CreativeRobotics/EnactiveTorchRT2b/README.md

# EnactiveTorchRT2b

Res
 Enactive Torch RT2 Hardware Revision b source files.
