CreativeRobotics/EnactiveTorchRT2b/Documentation/ETRT2BatteryStatement.pdf

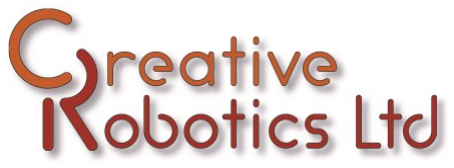
[picture p1: figure]

Copyright © Creative Robotics Ltd 2019

### www.creative-robotics.com support@creative-robotics.com

Enactive Torch RT 2.0

This device contains a 7.4 watt hour Lithium Battery fitted inside the equipment.

Battery specifications

Manufacturer: | RS Components
Manufacturer website: | www.rswww.com
Datasheet: | https://tinyurl.com/yyvgdmx6
Manufacturer part number: | 125-1266
Battery type: | polymer Li-ion Rechargeable Battery
Weight: | 40.0g
Nominal Voltage: | 3.7V
Nominal Capacity: | 2000Ah
Maximum Continuous Discharge Current: | 2000mA
