CreativeRobotics/EnactiveTorchRT2b/Documentation/ETRT2UserGuides_Revb.pdf

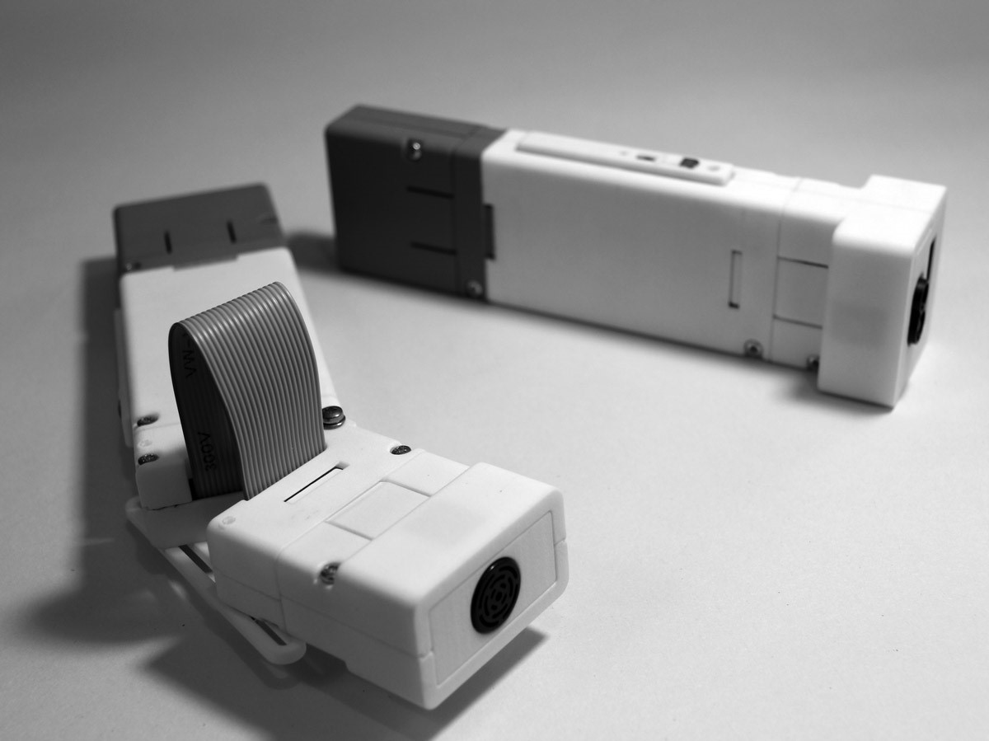
[picture p2: figure]

Copyright © Creative Robotics Ltd 2020 – DCU Hardware Revision b

www.creative-robotics.com
support@creative-robotics.com

# ENACTIVE TORCH RT 2 USER GUIDE

For DCU hardware Revision b

### Contents

### Introduction

The Enactive Torch RT 2 consists of three modules, a Data Capture Unit (DCU), input module and output module. The three modules clip together to form a working device.

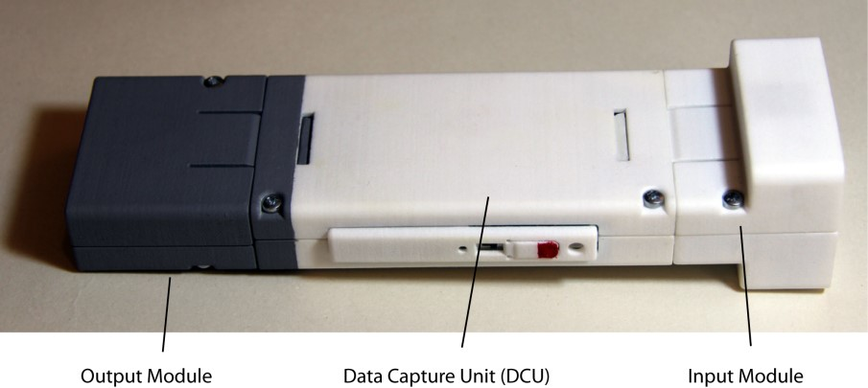
[picture p3: figure]

Data Capture Unit (DCU)
The Data Capture Unit is the core of the device. It contains the main processor, wifi module, inertial sensors and battery along with the user button and switch, USB port and micro SD card.

Input and output ports are located at each end of the DCU, one for a sensor input module and the other for the output module. The two ports use polarised connectors to prevent the modules being connected the wrong way around, and the case uses clip connectors to secure them in place. The two

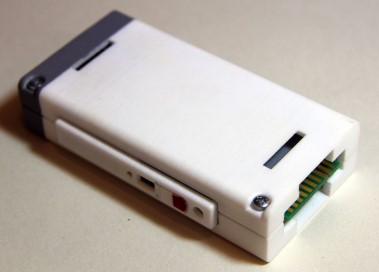
[picture p4: figure]

ends are also colour coded with the output module end coloured grey.

The USB port, power switch and SD card is located on one side of the DCU whilst the User LED, User button and switch and a device reset button are located on the opposite side.

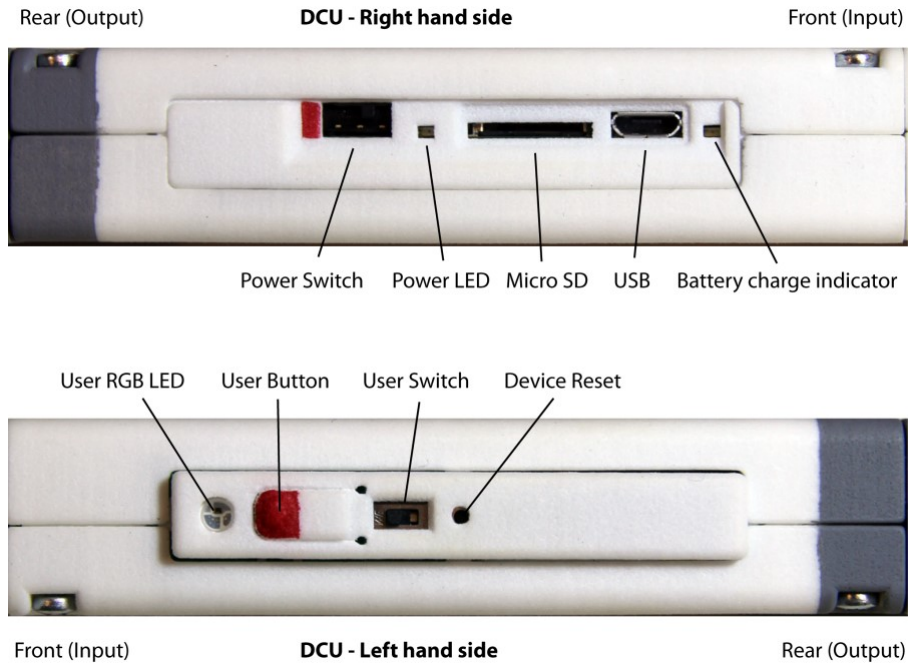
[picture p5: figure]

Clip connectors
The input and output modules connect to each end of the DCU. The connectors have white polarising pins that prevent them from being connected the wrong way.

Input Module

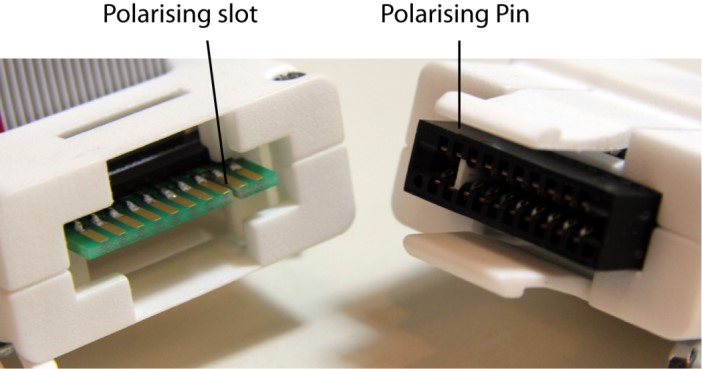
[picture p6: figure]

Input modules consist of a sensor or sensors that connect to the front of the device. A number of different input sensors can be connected to provide different functionality.

Sensor Modules

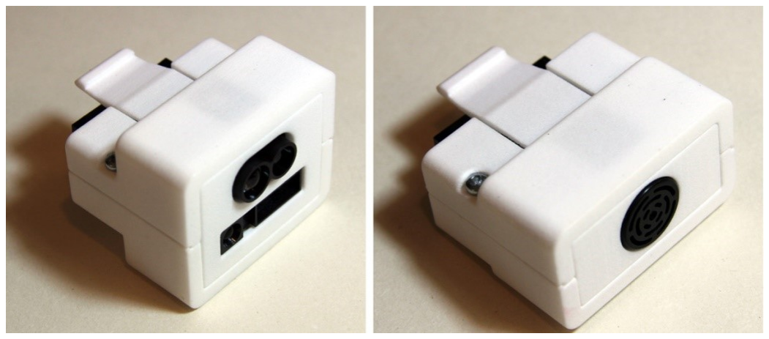
[picture p7: figure]

1: Two input modules - Dual LIDAR (Left) and Sonar (Right)

Output Module
The output module connects to the rear of the DCU and is used to produce output signals from the DCU, for example haptic feedback signals to drive different types of haptic actuator. More details can be found on page 13.

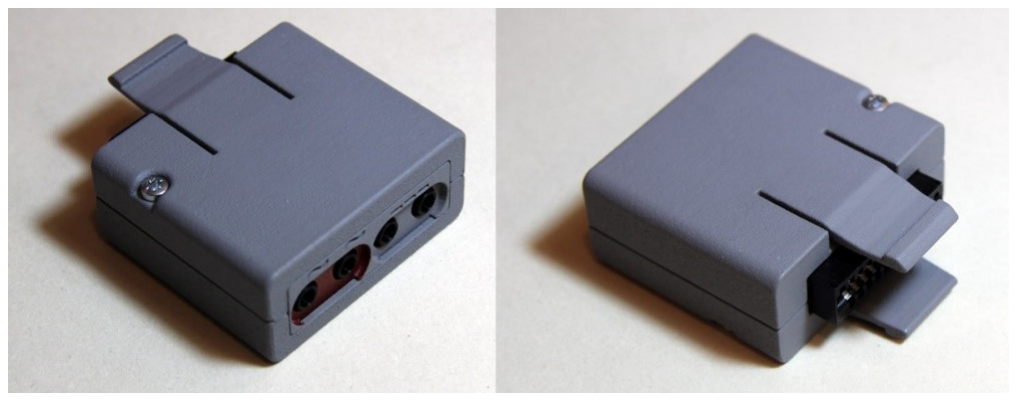
[picture p8: figure]

### Basic operation

Startup procedure
When the DCU is switched on it will check for the presence of an SD card and, if found, it will then look for a file called settings.txt.

If the settings file is found it will open it and read the contents which should be a series of commands for configuring the device.

The command system
The DCU has a text based command system that can be used to configure the device. Commands can be sent over a USB connection, by Bluetooth and by WiFi using Telnet (Some of these functions are not working yet)

Documentation for the commands can be found on page 15.

The settings file can also be used to issue commands when the device is switched on and is the primary way to control the devices configuration. In particular it can be used to instruct the WiFi module to connect to a WiFi access point using a specified password.

Entering commands via the USB port.
To enter commands using the USB port, first connect the DCU to a computer using a USB cable. Connect to the DCU using a terminal emulator or serial port application. If the Arduino IDE is installed then the in built Serial monitor can be used. The USB serial port settings are:
- 115200 baud
- 1 Stop bit
- No parity

The DCU will appear as an “Adafruit Metro M4 (SAMD51)” USB device.

When the DCU is connected and switched on and the Serial monitor is opened up, type the command ‘get status’ and press enter to read the device configuration status. To get a list of commands type ‘help’ and press enter.

### Software Installation

The DCU can be programmed using the Arduino development environment. The Arduino IDE is open source and free to download for PC, MAC and Linux. The DCU requires some additional files in order to work.

Installing and configuring Arduino
Download the version of Arduino for your computer from here:

https://www.arduino.cc/en/Main/Software

Follow the Arduino installation instructions for your system here:

https://www.arduino.cc/en/Guide/HomePage

Open Arduino and open File->Preferences. A dialog box will appear. At the bottom, click the button on the right of the text entry field called ‘Additional Board Manager URLs’ and paste the following onto a new line in the box before closing the dialog boxes and restarting Arduino.

https://adafruit.github.io/arduino-board-index/package_adafruit_index.json

Installing the Arduino and Adafruit SAMD cores
The code for the ETRT depends on several ‘core distributions’ for Arduino which contain essential code for the ETRT processors.

Open the Board manager in Arduino in Tools->Board->Boards Manager and search for’ samd’. Install the Arduino SAMD Boards (32-bits ARM Cortex-M0+) package.

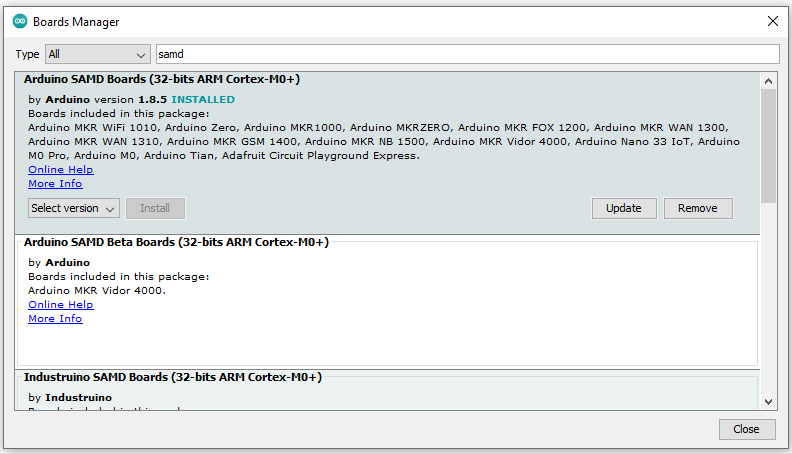
[picture p9: figure]

Now search for ‘Adafruit’ and install the ‘Adafruit SAMD Boards’ Package.

Installing the Creative Robotics Arduino core
The DCU works with a customised version of the Arduino software core, derived from the Adafruit SAMD core, which is in turn derived from the Arduino SAMD core. It can be downloaded from here:

https://github.com/CreativeRobotics/ArduinoCore-samd/archive/master.zip

1. Unzip the contents of the file.
2. The unzipped folder will be called ‘ArduinoCore-samd-master’ – Rename this to ‘samd’.

3. Locate the Arduino Sketch folder on your computer
4. Inside the sketch folder look for a folder called ‘hardware’ – if it does not exist then create it.
5. Inside the ‘hardware’ folder create another folder called ‘CreativeRobotics’.
6. Copy the ‘samd’ folder from step 2 into the ‘CreativeRobotics’ folder.

To check that the installation has worked properly start or restart the Arduino IDE and look in the Tools->Board menu. You should see a list of boards under the heading “Creative Robotics SAMD (32-bit ARM Cortex M0+ and M4) Boards”

Select the “Enactive Torch RT2 REVb (SAMD51)” option.

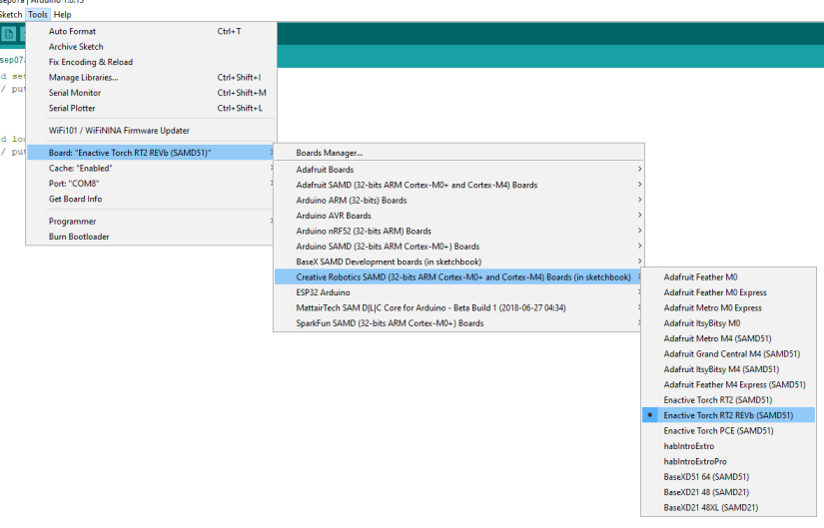
[picture p10: figure]

Installing the DCU firmware source code for Arduino
The full set of hardware and software for the ETRT2 revision B, including source code for the DCU firmware can be downloaded from here:

https://github.com/CreativeRobotics/EnactiveTorchRT2b/archive/master.zip

To set up the software to work with Arduino first unzip the files and locate the ‘ETRT-DCU1’ folder inside ‘Firmware/ (https://github.com/CreativeRobotics/EnactiveTorchRT2b/tree/master/Firmware)DCU/ (https://github.com/CreativeRobotics/EnactiveTorchRT2b/tree/master/Firmware/DCU)FW Revision B/ETRT-DCU1’ (https://github.com/CreativeRobotics/EnactiveTorchRT2b/tree/master/Firmware/DCU/FW%20Revision%20B) and copy this into your Arduino Sketchbook folder.

In order to compile the software you also need to install some third party libraries. This can be done with the Arduino Libraries manager.

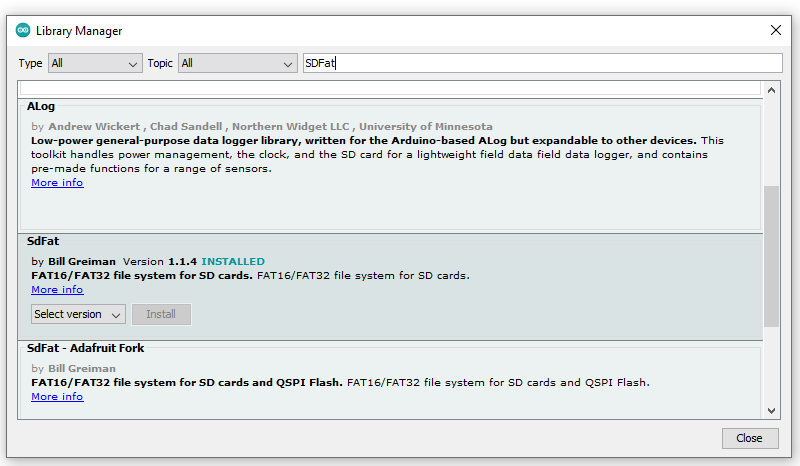
[picture p11: figure]

In the Arduino IDE open the ‘Sketch->Include Library’ menu and select ‘Manage Libraries…’.

Using the Library Manager, search for SDFat, and install the library.

When complete, restart Arduino, navigate to the location of the ETRT software in the sketchbook and open the file called ETRT-DCU1.ino.

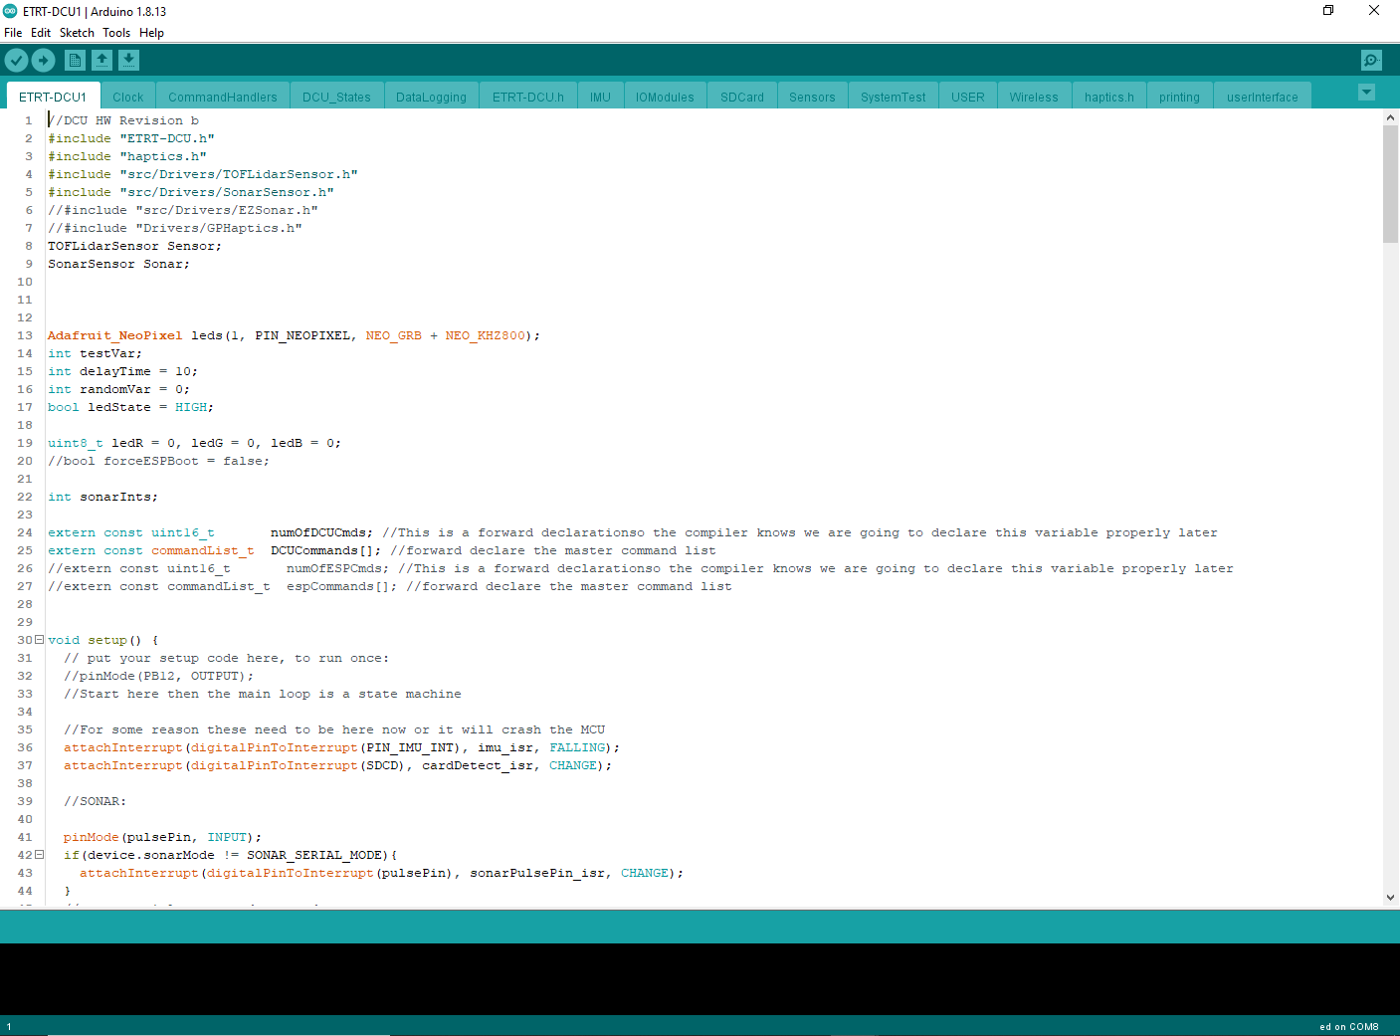
[picture p12: figure]

Connecting the DCU to Arduino
Attach the DCU to the computer using the USB cable and switch the DCU on. The computer should automatically recognise it as a USB serial device.

In Tools->Port the ETRT should be listed, it may be displayed with the name “Adafruit Metro M4 (SAMD51)” or “Enactive Torch RT2 Revb”. Select this as the serial port.

In Arduino, select Tools->Serial Monitor to open the serial port terminal. Set the baud rate to 115200 baud using the drop down menu next to the ‘clear output’ button.

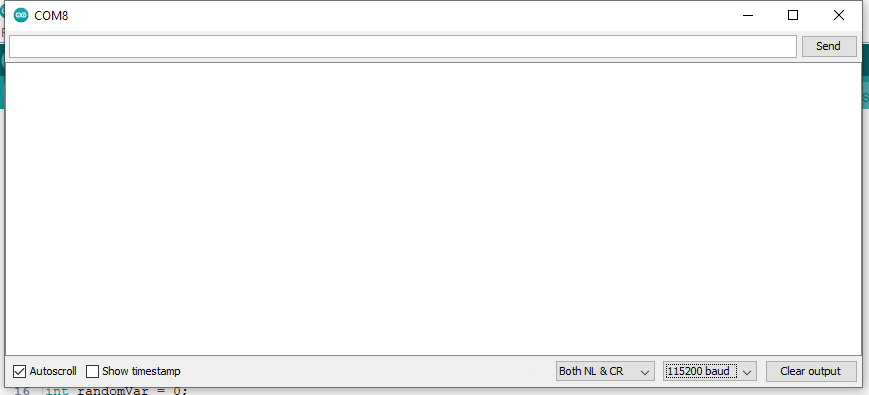
[picture p13: figure]

If the DCU has booted up and the serial monitor is connected the DCU should respond to the ‘help’ command by providing a list of commands.

To compile and upload code, click on the upload button in the Arduino IDE (The right facing arrow at the top left). The code will compile and then be uploaded to the DCU. If the Serial monitor is left open it will be greyed out during the upload and if the upload is successful the device will print boot status information as it restarts.

If the attempt to upload fails the Serial monitor should be closed and the DCU reset into bootloader mode. This can be done by pressing the reset button twice in rapid succession. The indicator LED will appear green when the device is in bootloader mode – When in this mode the device will appear as a different USB port, this port must be selected before attempting to upload code. If the upload is successful the device will re-appear as a new serial port which must then be selected before the serial monitor is reopened.

### Data Capture Unit

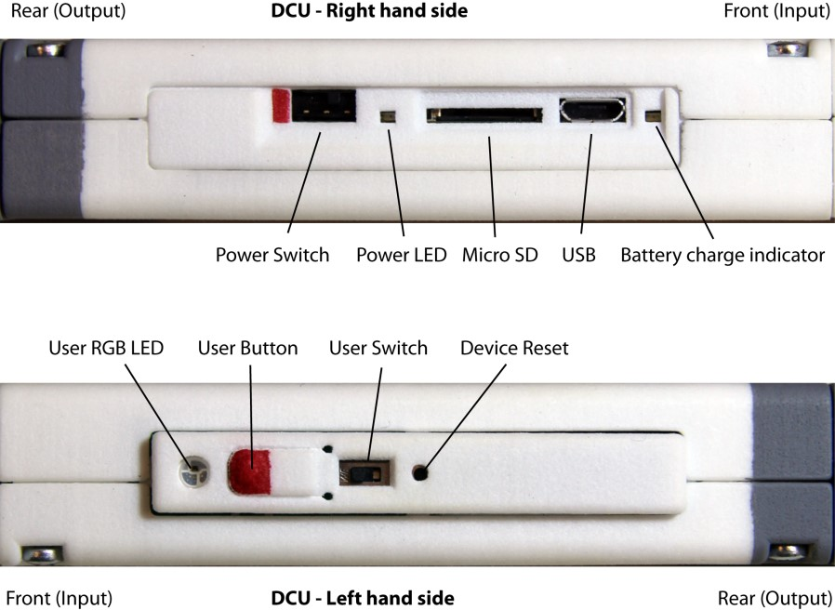
[picture p14: figure]

The Data Capture Unit (DCU) is the core of the device, it provides power, USB and wireless connectivity and supports the Micro SD card reader. It also incorporates a 9 axis inertial measurement unit to track the orientation of the unit.

The DCU has two connectors at each end, one for attaching a distance sensing module, and the other for attaching a haptic driver module. The connectors have a polarising pin so the haptic module can only be plugged into the output of the DCU. With these modules attached, the DCU can read range data from the distance sensor module and translate it to haptic signals. It can also log this and other sensor data to the SD card and broadcast it over a Bluetooth connection, or over WiFI using the UDP data protocol.

The power switch ON position is where the switch is slit towards the rear of the device (the grey end). The user switch is in the ON position when in the forward position (towards the front)

### Sensor Modules

There are currently two sensor modules that can be used with the DCU. The DCU will automatically detect the type of sensor that is attached to it when powered up.

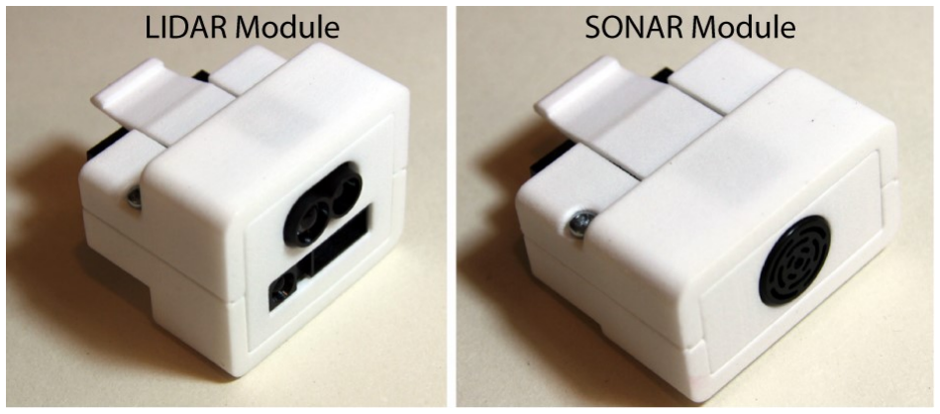
[picture p15: figure]

Lidar
The Lidar module uses a time of flight lidar sensor that measures distance by sensing out a pulse of infra-red light and measuring the time it takes to receive a return signal. This sensor can measure distances between 30cm and 1200cm with a resolution of 1cm and a frequency of 100Hz.

The module also incorporates a second infra-red rangefinder that can measure distances from 4cm to 30cm.

Details of the Lidar and IR rangefinder cab be found here:

https://www.seeedstudio.com/Seeedstudio-Grove-TF-Mini-LiDAR.html

http://www.sharp-world.com/products/device/lineup/data/pdf/datasheet/gp2y0a41sk_e.pdf

Sonar
The sonar module uses ultrasonic sound to measure distance. The sensor is an MB1010 LV-MaxSonar-EZ1 sensor from Maxbotics. It can measure distances between 15cm and 645cm with a resolution of 2.54cm and a frequency of 20Hz.

https://www.maxbotix.com/documents/MB1010_Datasheet.pdf

### Haptic Modules

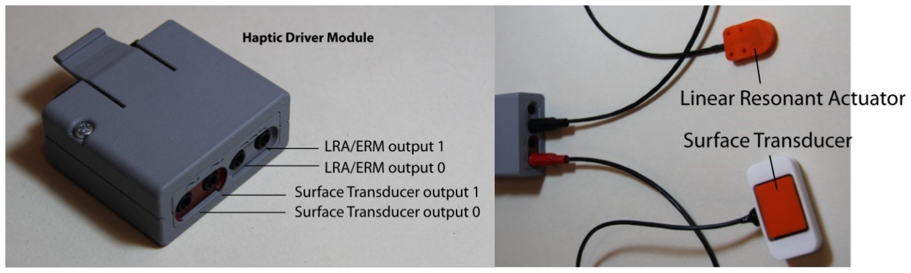
[picture p16: figure]

ERM/LRA and Surface Transducer module
This module combines two types of haptic driver, each with two channels.

ERM/LRA drivers
The ERM/LRA drivers control conventional vibration motors and can be configured in software for two modes of operation:

In LRA mode it will drive Linear Resonant Actuators, these are a type of vibration motor containing a magnetic coil, mass and spring, and will resonate at a certain frequency when driven correctly and allow the intensity to be controlled. The LRA actuators supplied with the module will resonate at approximately 200Hz.

In ERM mode the device can drive Eccentric Rotating Mass actuators. These are conventional miniature motors with an eccentric mass attached to their output shaft which causes them to vibrate when the motor is spinning. The speed of the motor, and consequently the intensity of the vibration, can be controlled in software. With these actuators the vibration frequency and intensity are coupled together so increasing intensity also increases frequency.

Surface Transducer drivers
The surface Transducer drivers produce class B audio signals using a 2.5 audio Watt amplifier. They can be used to drive surface transducers. These are a type of actuator consisting of a magnetic coil and magnet and operate in exactly the same way as audio loudspeakers.

Surface transducers allow for independent control over frequency and intensity so it is possible to map two different sensor signals into their haptic output.

The default mode of operation for the surface transducers is conventional sensor to intensity mapping where the actuators are driven by a sine wave of varying intensity. A number of different signals can be chosen for driving the module this way, for example triangle waves and saw tooth waves.

### Getting started

Default firmware behaviour
The DCU will come with default firmware installed, and a default settings.txt file on the SD card. With the default firmware installed, the device will operate as follows.

The user button activates the sensor to haptic mapping and will trigger data capture. Pressing the user button will toggle between active and inactive modes, and the LED will change colour to indicate which mode it is in.

When the device is active, sensor inputs will be mapped to all four haptic outputs and data will be logged to the data channels as specified below, when the device is inactive, the haptic outputs are disabled and data streaming is halted.

The user switch controls whether data is just streamed over USB and wireless connections, or whether it is also logged to an SD card. The streaming options for the device are controlled using the start up configuration which the device reads from the ‘settings.txt’ file on the SD card. By default streaming over USB is enabled.

When the user switch is in the OFF position (towards the rear) and the user button is pressed, the DCU will stream data over USB and any wireless connection it has been configured to use.

When the switch is ON (toward the front) the DCU will create an SD log file whenever the user button is pressed, and log data to this file for as long as the user keeps the button pressed. When the user releases the button the log file is closed. The DCU will also stream this data over any connection it has been configured to use.

### Configuring the DCU

The DCU has a set of commands that can be used to control configuration. These Commands can be accessed using the USB port and a Serial Terminal application, or through a wireless connection such as Bluetooth or Telnet.

The settings file
The default configuration when the device starts up can be controlled with the same command set, but with a file on the SD card. When the DCU is switched on it will look for an SD card and for a file called ‘settings.txt’. If it finds this file it will read and process any commands in the file.

The settings file MUST include a blank line at the end of the file.

A full list of commands can be found in the next section.

Example settings file

#ETRT SETTINGS

#DCU SETTINGS

#Lines starting with HASH (#) are ignored DEBUG:if the settings file is empty thats fine #Data log settings - what to log

setlog quaternion false
setlog YPR true
setlog gyro false
setlog accellerometer false setlog magnetometer false
setlog heading false
setlog inputs true
setlog outputs true
#Data log settings - where to log setlog USB false

setlog UDP false
setlog SD false
setlog bluetooth false
#Set biases for IMU

#set gyro bias 0,0,0

#set accel bias 0,0,0

#set mag bias 0,0,0

#use for configuring wifi

#set SSID myssid

#set set Pass mypassword

enable bluetooth

Anything preceded by the # symbol will be ignored so this symbol can be used to insert comments or disable commands. The command DEBUG can be used to print messages – anything after a DEBUG command will be printed over the USB port.

The first group of settings all use the ‘setlog’ command to configure which different parameters will be logged to file, and streamed over any data connections.

The second set of ‘setlog’ commands will enable or disable different channels for data logging. In the example only USB is enabled by default – but during operation logging to SD card can be switched ON or OFF with the user switch.

The next set of commands set bias values for the inertial measurement unit. These will normally be unique to each device and can be obtained by performing a calibration run (To Be Done)

The next set of commands set the network name (SSID) and password for WiFi conections. These are only used if the WiFi service is subsequently enabled. The command to enable WiFi must be used AFTER the password and SSID commands.

The final command enables the communications module as a Bluetooth device. This can be changed to enable WiFi and one of the WiFi services if required.

The DCU can use Bluetooth and WiFi simultaneously but the connections may become unreliable so it is best to use only one of these services.

### DCU Command List

Note: This is a list of all command words that the device recognises. Some are only used for device to device communication, for example the ack and nack commands are simple acknowledge messages, and the DEBUG: command marks a command as containing debug information which it should simply ignore.

get status

Arguments: none

Returns:

get device status information

set time

Arguments: HH:MM:SS

Returns:

set the time. Syntax: set time [HH]:[MM]:[SS] – Hours, Minutes and Seconds separated with a colon.

get time

Arguments: none

Returns:

get the device time

set date

Arguments: DD:MM:YYYY

Returns:

Set the date Syntax: set time [DD]:[MM]:[YYYY]

get date

Arguments: | none
Returns: | none

Get the device date

get raw voltage

Arguments: none

Returns:

Get the device raw voltage reading

get settings

Arguments: none

Returns:

Print out the device settings

set precision

Arguments: integer - for example 4 (4 decimal places)

Returns:

Sets the number of decimal places for data logging. Example: set precision 5

set aux power

Arguments: on / off

Returns:

Turn the auxiliary 5V power regulator on or off. Syntax: set aux power on

sleep

Arguments: | none
Returns: | none

Puts the device to sleep – COMMAND NOT FUNCTIONAL

restart

Arguments: | none
Returns: | none

restarts the DCU

set SSID

Arguments: SSID name

Returns:

Sets the SSID for WiFI. Syntax: set SSID mydssidname

set Pass

Arguments: Network Password

Returns:

Sets the password for WiFI. Syntax: set Pass mypassword

enable server

Arguments: none

Returns:

Starts the HTTP server

disable server

Arguments: none

Returns:

Stope the HTTP server

enable telnet

Arguments: none

Returns: none

Starts the Telnet service

disable telnet

Arguments: | none
Returns: | none

Stops the Telnet service

enable bluetooth

Arguments: | none
Returns: | none

Starts the Bluetooth service

disable bluetooth

Arguments: | none
Returns: | none

Stops the Bluetooth service

enable UDP

Arguments: | none
Returns: | none

Starts the UDP service

disable UDP

Arguments: | none
Returns: | none

Stops the UDP service

startlog

Arguments: | none
Returns: | none

Starts logging data to the configured data channels

stoplog

Arguments: | none
Returns: | none

Stops logging data

setlog

Arguments: | setlog sub command + true/false
Returns: | none

Configure which types of data are to be logged and where to send it (SD, USB, UDP, Bluetooth).

Examples:

setlog quaternion true

setlog USB true

Sub command list:

quaternion | 4 axis quaternion IMU data
YPR | Yaw Pitch and Roll data
gyro | Gyro XYZ data
accel | Accelerometer XYZ data
mag | Magnetometer XYZ data
heading | Heading (compass) data
inputs | Device sensor inputs
outputs | Device haptic outputs

SD | Enable/Disable SD card logging
UDP | Enable/Disable UDP data streaming
Bluetooth | Enable/Disable Bluetooth data streaming
USB | Enable/Disable USB data streaming

get log header

Arguments: none

Returns: String of text

Gets the header for the log file with names for each column of data as specified by the log configuration.

SD

Arguments: | none
Returns: | none

Invokes the SD file navigation sub commands.

This command will load a sub command list with some basic SD file navigation commands. These commands can
| be viewed using the ‘help command.

start haptest

Arguments: | none
Returns: | none

Start testing the haptics

stop haptest

Arguments: | none
Returns: | none

Stop testing the haptics

set waveform

Arguments: | Chanel WAVEFORM
Returns: | none

Set the waveform type.

Example: set waveform 0 SINE

Sets the waveform for channel 0 to a sine wave.

Waveform arguments:

SINE | Sine wave
SQUARE | Square wave
TRIANGLE | Triangle wave
SAWF | Sawtooth (forwards)
SAWB | Sawtooth (reverse)
ONESHOT | (Single pulse sequence)
HALFSHOT | (Half pulse sequence)

set gyro bias

Arguments: | x,y,z
Returns: | none

Set the Gyro bias values with three comma separated integers. Syntax:set gyro bias [x],[y],[z]

set accel bias

Arguments: | x,y,z
Returns: | none

Set the Accelerometer bias values with three comma separated integers. Syntax:set accel bias [x],[y],[z]

set mag bias

Arguments: x,y,z

Returns: none

Set the magnetometer bias values with three comma seperated integers. Syntax:set mag bias [x],[y],[z]

ESP Boot

Arguments: | none
Returns: | none

Restart the ESP32 wifi module in bootloader mode

ESP RESET

Arguments: | none
Returns: | none

Reset the ESP32 wifi module

ESP Status:

Arguments: | none
Returns: | none

An ESP32 WiFi module Status message.

ESP Get:

Arguments: | none
Returns: | none

Marks HTML data sent to the WiFI module for it to send to a client.

ESPTelnet:

Arguments: | none
Returns: | none

Marks data as coming from a Telnet client.

ESP:

Arguments: | none
Returns: | none

Route the command to the ESP32 WiFi Module.

testSD

Arguments: | none
Returns: | none

Test the SD by opening writing and closing a file.

button action

Arguments: | sub command + true/false
Returns: | none

Enable or disable various button actions. This determines the behaviour of the user button with the default firmware. The three sub commands that can be used are as follows, and should be followed by either ‘true’ or ‘false’.

- | enable haptics | enable the haptics on a user button event
- | enable log | enable data logging on a user button event
- | enable toggle | enable toggling of user button events

By default all are set to true. When ‘enable toggle’ is true the user button will toggle between active and inactive modes. When set to false, pressing the user button will trigger active mode and releasing it will return to inactive mode.

In active mode, haptics and data logging are also active IF they have been enabled as button actions.

In inactive mode haptics and data logging will be inactive.

DEBUG:

Arguments: | none
Returns: | none

Debug message.

ack

Arguments: | none
Returns: | none

Acknowledge.

nack

Arguments: | none
Returns: | none

NOT Acknowledge.

toggle print

Arguments: | none
Returns: | none

Toggle Printing (DEBUGGING).

?

Arguments: | none
Returns: | device information

Query -

help

Arguments: | none
Returns: | help file

Gets a page of information about the current command set.

### ESP32 command list

Command list for the ESP32 WiFi Module. These commands are used by the WiFi/Bluetooth module and are used by the DCU to control the WiFi module..

?

Arguments: None

Query – Returns ack.

Help

Arguments: None

Returns command list.

Ack

Arguments: None

Send an acknowledge.

Nack

Arguments: None

Send a NOT acknowledge.

enable server

Arguments: None

Enable the HTTP Server.

disable server

Arguments: None

Disable the HTTP Server.

enable Bluetooth

Arguments: None

Enable the Bluetooth Serial service.

disable Bluetooth

Arguments: None

Disable the Bluetooth Serial service.

enable UDP

Arguments: None

Enable the UDP broadcast service.

disable UDP

Arguments: None

Disable the UDP broadcast service.

UDPSend:

Arguments: UDP data packet

Send a packet of data over the UDP service.

Example: UDPSend:Sensor=123,Gyro=992

serverSend:

Arguments: HTML line

Send a line of data for the HTTP server to send to a client.

Example: serverSend:<p>some HTML</p>

BTSend:

Arguments: Bluetooth serial data

Send a line of data for transmission via Bluetooth.

Example: BTSend:Sensor=123,Gyro=992

serverEnd

Arguments: None

Tell the server to close the connection to the client – When everything that needs to be sent has been sent.

set UDPPort

Arguments: UDP Port number

Sets the UDP Port number.

Example: set UDPPort 6060

set UDPAddress

Arguments: UDP network address

Sets the network address for UDP data. Default is broadcast address.

Example: set UDPAddress 123.456.789.101

set SSID

Arguments: SSID (Network Name)

Sets the WiFi network name to connect to.

Example: set SSID VM12345

set Pass

Arguments: WiFi Password

Sets the WiFi password.

Example: set Pass mypassw0rd

set Server Timeout

Arguments: time in milliseconds

Sets the timeout period in milliseconds after which the HTTP server will close a client connection.

set BTName

Arguments: Bluetooth device name.

Sets the Bluetooth device name.

Example: set BTName ETNumber2

connect to

Arguments: SSID and Password (Separated by one space)

Attempts to connect to a WiFi network using the SSID and Password in the arguments.

Example: connect to VM12345 mypassw0rd

set WiFi Timeout

Arguments: Time in milliseconds

Sets the timeout period after which an attempt to connect to WiFi is abandoned. Minimum is 1000 (1 Second).

Example: set WiFi Timeout 10000

Disconnect

Arguments: None

Disconnects from WiFi.
