CreativeRobotics/EnactiveTorchRT2b/Hardware/PerceptualCrossing/Display Head Disassembly.txt

Follow this link to view a video file of the disassembly steps.

https://www.dropbox.com/s/dvkhhiwpnt47x4t/Disassembly%20Animation.avi?dl=0
