CreativeRobotics/EnactiveTorchRT2b/(threads)

Thread 1 (2020-04-20):

LIDAR distance jumps to high values

kercos, 2020-04-20:
When opening the serial plotter we noticed that LIDAR distance signal (blue line) at random time (usually when you move the torch) jumps to very high levels (>>12000) for few data points. See attached screenshots.
This problem does not occur with SONAR input.

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

CreativeRobotics, 2020-04-29:
The LIDAR modules are supposed to send a checksum as part of a data packet, but when tested the checksum was always 0 - this may be a firmware bug in the devices. Without a checksum it is not possible to establish if a packet is valid or not so errors can appear as unusual values. I've attempted to mitigate this by capping the raw data values to within the measurement range of the device. If this still causes problems then some additional filtering may be required. (The files for this and other fixes will be released in the next few days).

I don't currently have a LIDAR module to test updated code with, but I have just ordered one.

Closed 2020-04-29.

Thread 2 (2020-04-20):

SONAR doesn’t trigger haptic outputs

kercos, 2020-04-20:
SONAR input value seems reliable but when connecting haptic modules in output nothing happens.
The same haptic modules work if the input unit is LIDAR.

CreativeRobotics, 2020-04-30:
I've been testing this with the unit I have here and I do get normal haptic outputs with the sonar module - both for the Linear Resonant Actuator haptics and the Surface Transducers. I will finish up a few more tests and then update the code in the repo with the updates for other issues, then we will have to look at this issue again.

CreativeRobotics, 2020-04-30:
Remember - you cannot hot swap the sensor modules at the moment. The sensor type recognition happens during power up so changing them when the device is powered on will cause it to misbehave. I will look at changing this because I imagine hot swapping might be useful.

kercos, 2020-05-04:
@CreativeRobotics Update on this issue.
I've tried again and found out that with SONAR input only Surface Transducer works but very faintly and only on a very short range (max 10cm). It works also when I connect it after booting the device.
But with LRE/ERM sensor I could still not perceive any haptic feedback even when connected before booting the device.

Thread 3 (2020-04-20):

CSV output extra column

kercos, 2020-04-20:
Output in the CSV has one more column wrt the headers (IMU heading value is always printed).

CreativeRobotics, 2020-05-08:
This should be fixed now

Closed 2020-05-08.

Thread 5 (2020-04-20):

Update SONAR to user original driver

kercos, 2020-04-20:
SONAR original driver not being used and not reading incoming serial bytes.

CreativeRobotics, 2020-04-29:
SONAR will not work with serial because the serial data is inverted - it appears the Maxbotics SONAR module outputs serial data at logic level, but inverted as if sent via RS232. The SERCOM hardware module  cannot be configured to read inverted serial values so the only way to make this work is with additional hardware to invert the SONAR serial stream.

The default SONAR data read mode is to read PWM pulse lengths. The SONAR module outputs a PWM signal with a pulse of 147us per inch. This is read using interrupts to capture the pulse length, and is converted to cm.

Closed 2020-04-29.

Thread 6 (2020-04-20):

Enable printing of debug messages in code

kercos, 2020-04-20:
There seems to be no way to enable the printing of debug messages in the code.
There seems to be the `toggle print` command specific for this purpose, but it doesn't seem to work.
I've noticed that in the last commit (https://github.com/CreativeRobotics/EnactiveTorchRT2b/commit/e379dda2c45291f696694369003d7f4c07e5214f) this command has been replaced by `debug` but this is not being recognized. Is it because we need to update the code in each ESP32 board? If so, how can we do that?

CreativeRobotics, 2020-05-04:
The debug command in the latest comit worked fine for me, and I get debug messages when it is enabled. I will upload a new commit soon, and double check that all the uploaded files are correct - there could be a discrepancy between what I have on my system and what got uploaded to github...

CreativeRobotics, 2020-05-08:
I've updated the repo and added more debug support, including saving debug settings to the devices flash memory so they will be loaded the moment the device starts - this allows debug data to be enabled from before the SD card settings file is read.

Closed 2020-05-08.

Thread 7 (2020-04-23):

Perceptual Crossing Documentation

kercos, 2020-04-23:
Need documentation for  PerceptualCrossingApp in
`EnactiveTorchRT2b/Apps/PerceptualCrossing/PerceptualCrossingApp.pde`.

kercos, 2020-04-23:
I've tried to open the PerceptualCrossingApp.pde using latest version of Processing (3.5.4) and installed the required library (controlP5).

I've notice that in one of the two devices one LCD screen is not properly working, the screen jitters as if the internal connection is not stable. I've tried disconnecting and reconnecting it again but it doesn't help.

I've then connected the tracking ball and button boxes to the devices and the devices to the compute via usb. When running the app, I went to the SERIAL PORTS tab to activate the communication. I selected the correct ports in the drop down menus and clicked on the the two units connect buttons. Both units would beep and the one with the LCD working would display READY.  At this point I could see the bars moving in the app when I would move both tracking balls, but I could not detect any haptic feedback.

I went back to the main tab and tried clicking on the various button "Manual Mode", "Free Practice Mode", "Start Trial", "Start Round" but I could not understand properly what each mode was supposed to do. In several situation I got the app stuck and some exceptions appearing in the console output.

CreativeRobotics, 2020-04-29:
Can you check the faulty LCD screen by plugging it into the other device to see if the problem persists - I want to know for certain if it is the screen module, or the DCU, that is faulty.

CreativeRobotics, 2020-04-29:
I've started work on documentation for the perceptual crossing app [here](https://github.com/CreativeRobotics/EnactiveTorchRT2b/wiki/Perceptual-Crossing-app)

kercos, 2020-05-04:
@CreativeRobotics I've tried to connect the faulty LCD screen in the other device and still it doesn't work properly, so it seems an LCD issue.

kercos, 2020-05-04:
@CreativeRobotics thanks for starting the documentation. Even though one LCD was not showing anything I was able to go through a trial round. Following you instructions I could see the buttons lighting up when pressed. But I wasn't able to perceive any haptics or audio feedback. Is there any specific configuration the output modules need to be setup?

CreativeRobotics, 2020-05-04:
I'll get back to you on the haptics issue - I don't have a full set of kit for the perceptual crossing experiments here so I need to rig up something to test it with. I will try and work out some instructions for disassembling the screen, its possible it got damaged during shipping.

Thread 8 (2020-05-04):

Updated the ESP32 boards with code changes

kercos, 2020-05-04:
Something which is not entirely clear to me is how to updated the ESP32 boards with the changes in the code.

kercos, 2020-05-04:
**Reply from Creative Robotics Tech Support**

The ESP32 is tricky because I discovered during development that using the main microcontroller as a USB to serial bridge for programming the ESP32 would not work. Apparently it is something to do with the USB peripheral firmware and the ESP32 bootloaders need for very tight timing of data during code uploads. The only way I could get the ESP32 to accept software was through a programming header I included on the main PCB.

For the revision B hardware I used an ESP32 with 16Mb flash memory and included provision in the code for over the air updates which can be triggered via a command. I haven't documented the commands required to initiate it properly but I did test it before I shipped the devices and I was able to upload new code to the ESP32 using a web browser.

My existing code that handles interactions between the ESP32 and the rest of the system is extremely poor and consequently a lot of it doesn't work properly. I am revising this as part of the updated code to make it work better - the main change will be to use a digital pin connection that exists between the two devices as a way of signalling whether serial data sent to the ESP32 is a command for the ESP32 to execute, or data that should be transmitted. (This digital connection is normally used to enable bootloader mode on the ESP32 as it powers up)

I will try and get you an explanation of the ESP32 upload process soon.
