CreativeRobotics/EnactiveTorchRT2b/Hardware/DCU/ETRT_DCU_Revisionb_Schematic.pdf

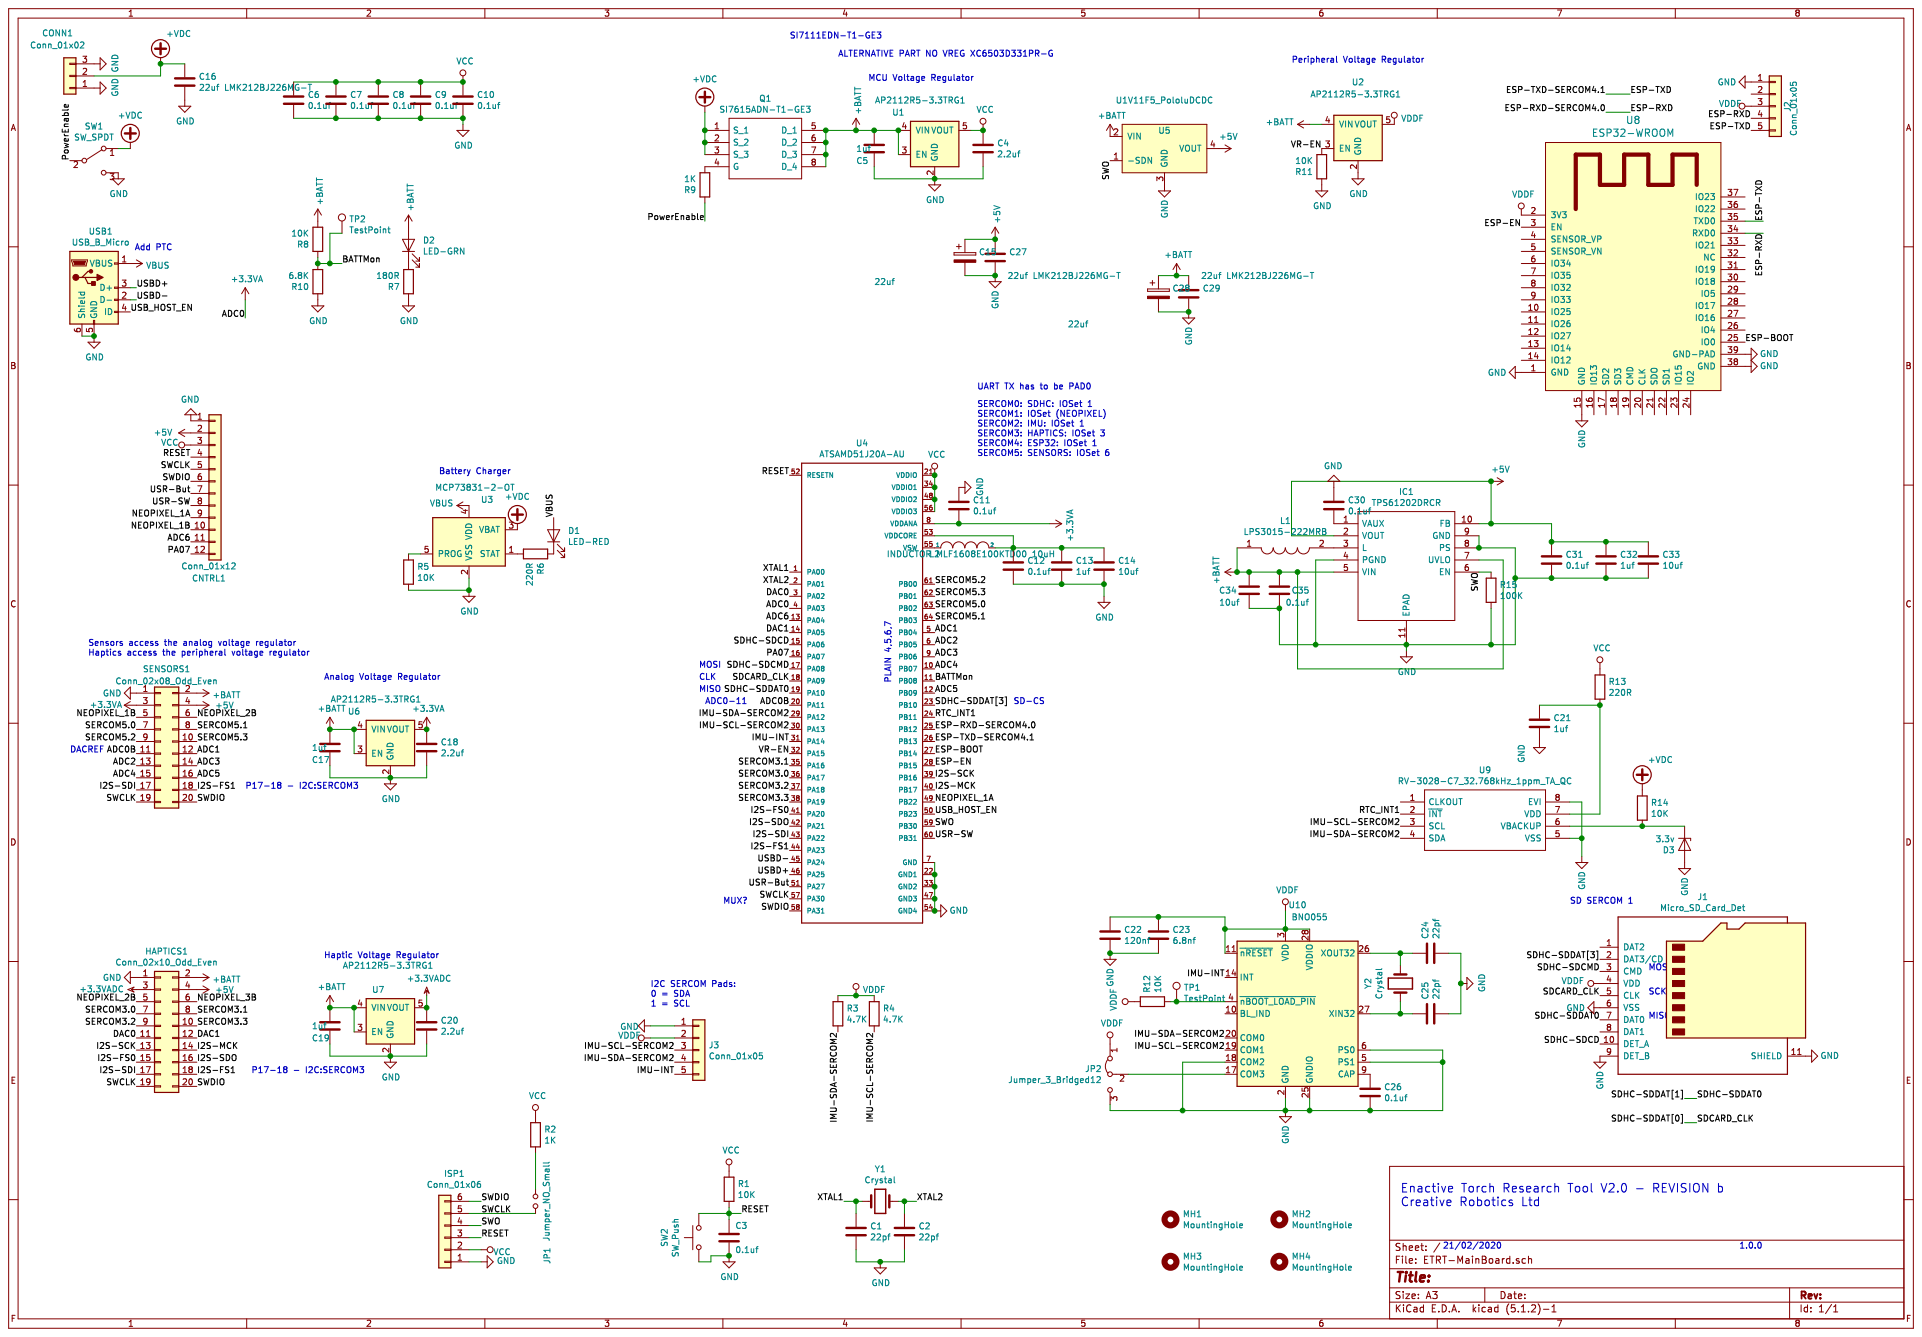
[picture p17: page 1]
