CreativeRobotics/EnactiveTorchRT2b/Hardware/Haptic1/HapticBoardV2Schematic.pdf

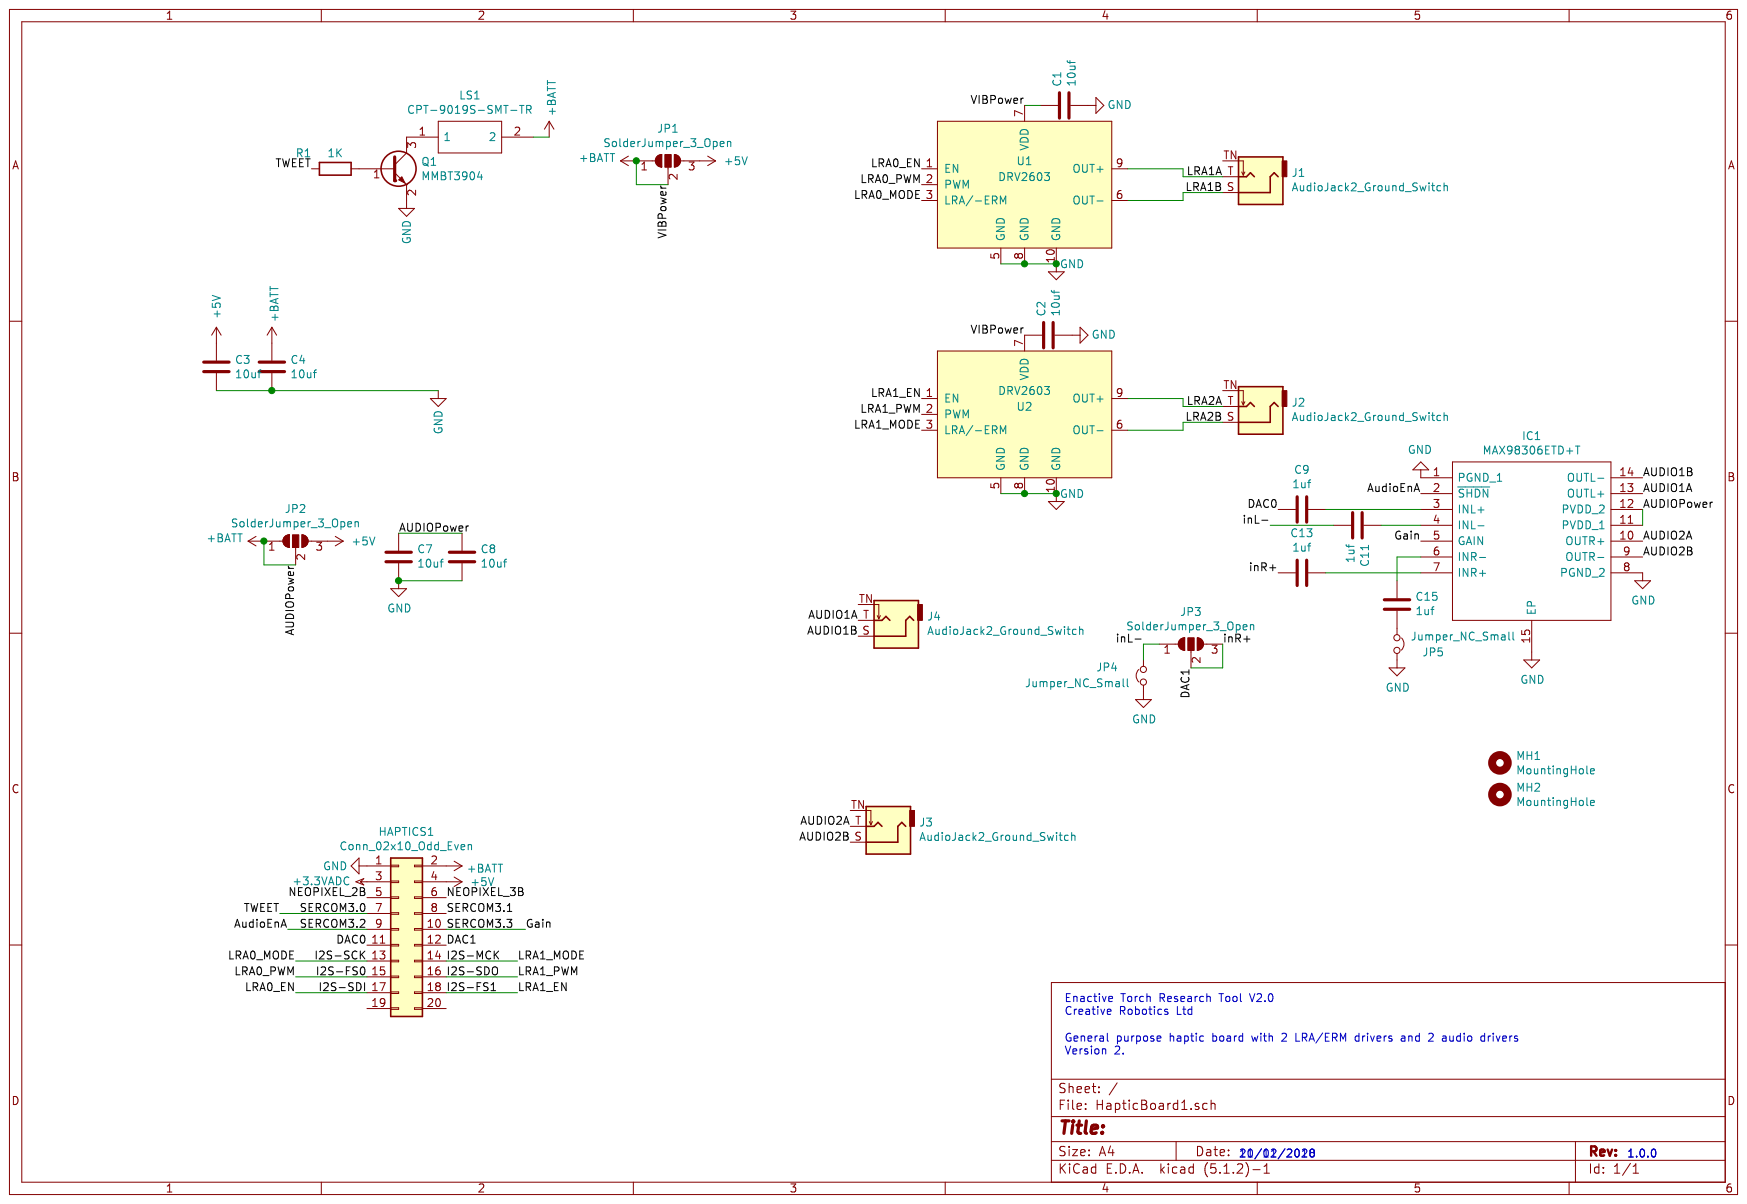
[picture p18: page 1]
