CreativeRobotics/EnactiveTorchRT2b/Hardware/PerceptualCrossing/PerceptualCrossingSchematic.pdf

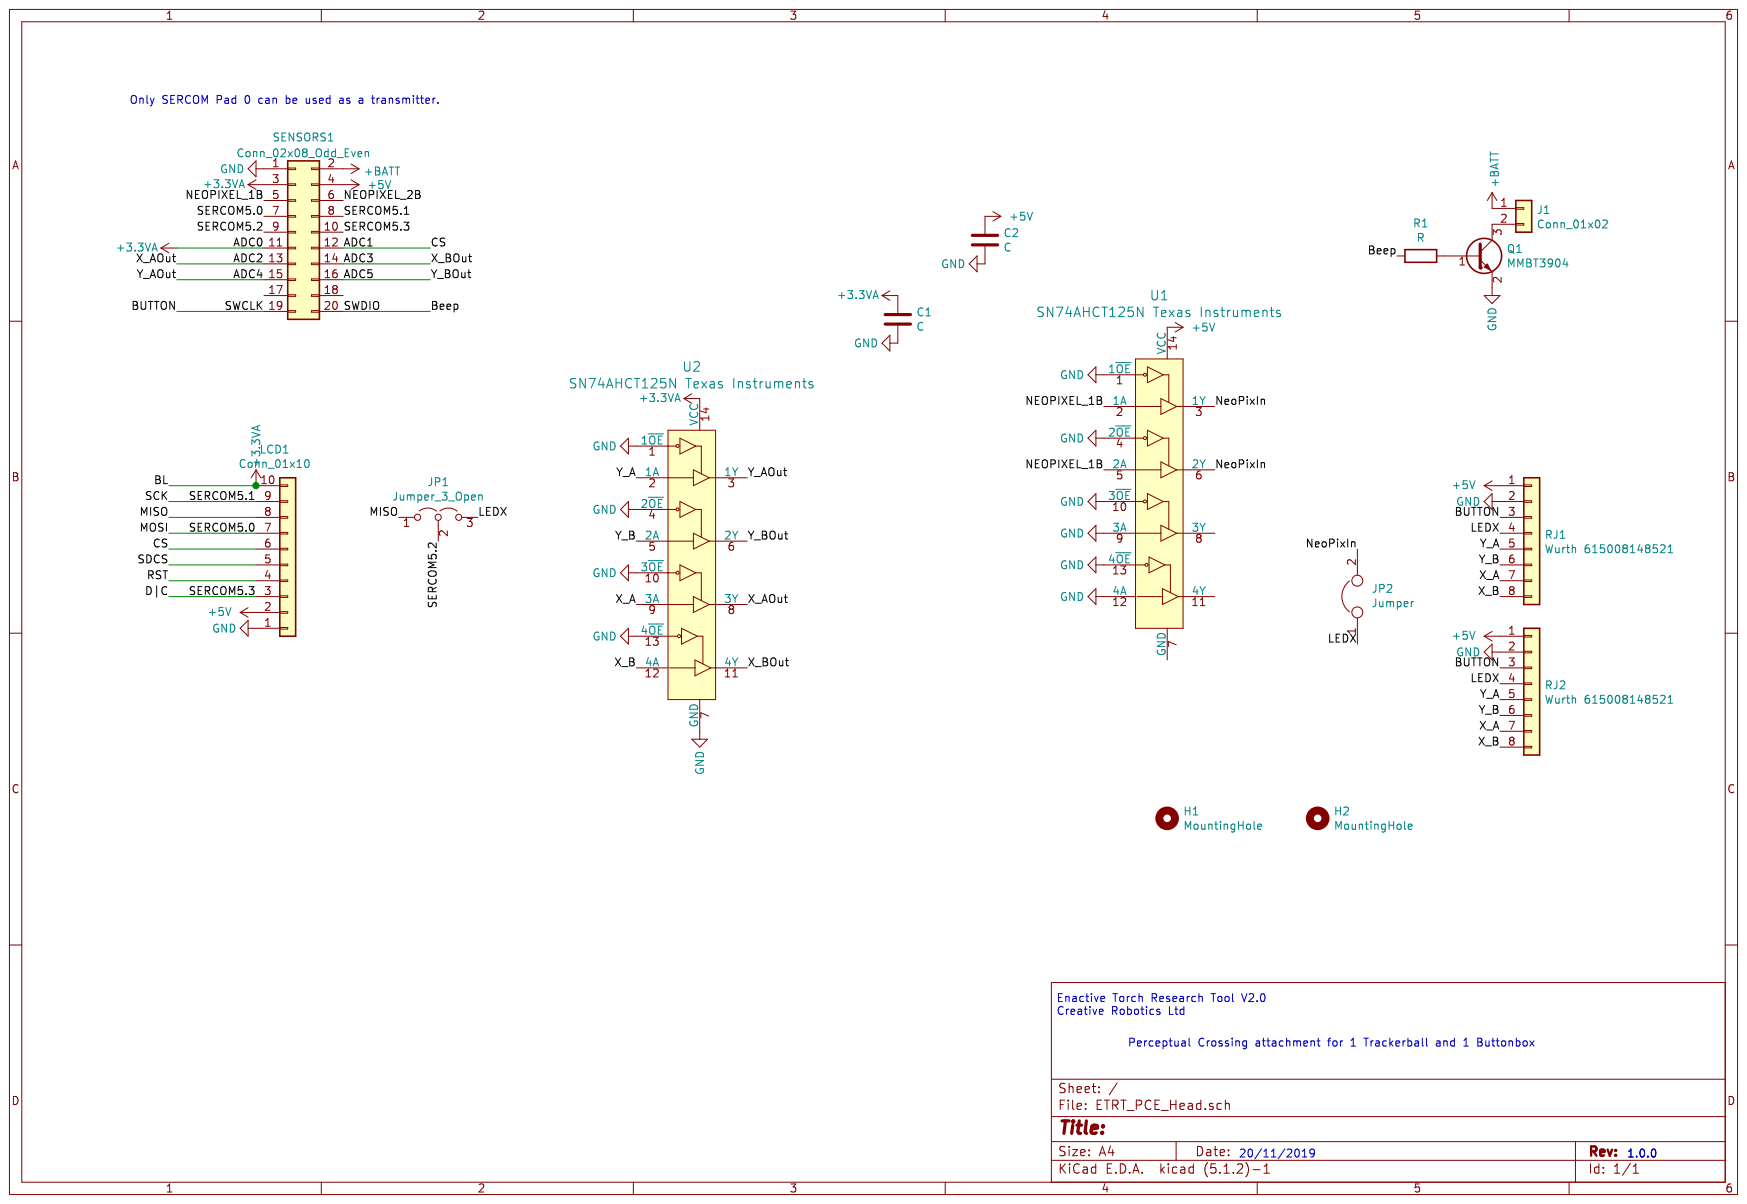
[picture p19: page 1]
