CreativeRobotics/EnactiveTorchRT2b/Firmware/DCUPerceptualCrossing/ETRT_PCE_Firmware/tft.ino

void tftTest(){
  Serial.print("Start: ");
  Serial.println(micros());
  tft.setFont();
    // read diagnostics (optional but can help debug problems)
  uint8_t x = tft.readcommand8(ILI9341_RDMODE);
  Serial.print("Display Power Mode: 0x"); Serial.println(x, HEX);
  x = tft.readcommand8(ILI9341_RDMADCTL);
  Serial.print("MADCTL Mode: 0x"); Serial.println(x, HEX);
  x = tft.readcommand8(ILI9341_RDPIXFMT);
  Serial.print("Pixel Format: 0x"); Serial.println(x, HEX);
  x = tft.readcommand8(ILI9341_RDIMGFMT);
  Serial.print("Image Format: 0x"); Serial.println(x, HEX);
  x = tft.readcommand8(ILI9341_RDSELFDIAG);
  Serial.print("Self Diagnostic: 0x"); Serial.println(x, HEX); 
  
  Serial.println(F("Benchmark                Time (microseconds)"));
  delay(10);
  Serial.print(F("Screen fill              "));
  Serial.println(testFillScreen());
  delay(500);

  Serial.print(F("Text                     "));
  Serial.println(testText());
  delay(3000);

  Serial.print(F("Lines                    "));
  Serial.println(testLines(ILI9341_CYAN));
  delay(500);

  Serial.print(F("Horiz/Vert Lines         "));
  Serial.println(testFastLines(ILI9341_RED, ILI9341_BLUE));
  delay(500);

  Serial.print(F("Rectangles (outline)     "));
  Serial.println(testRects(ILI9341_GREEN));
  delay(500);

  Serial.print(F("Rectangles (filled)      "));
  Serial.println(testFilledRects(ILI9341_YELLOW, ILI9341_MAGENTA));
  delay(500);

  Serial.print(F("Circles (filled)         "));
  Serial.println(testFilledCircles(10, ILI9341_MAGENTA));

  Serial.print(F("Circles (outline)        "));
  Serial.println(testCircles(10, ILI9341_WHITE));
  delay(500);

  Serial.print(F("Triangles (outline)      "));
  Serial.println(testTriangles());
  delay(500);

  Serial.print(F("Triangles (filled)       "));
  Serial.println(testFilledTriangles());
  delay(500);

  Serial.print(F("Rounded rects (outline)  "));
  Serial.println(testRoundRects());
  delay(500);

  Serial.print(F("Rounded rects (filled)   "));
  Serial.println(testFilledRoundRects());
  delay(500);

  Serial.println(F("Done!"));
  initTft(screenRotation);
  clearPrintMessage("Screen test complete", 0, displayYCentre, 1);
  
  Serial.print("End: ");
  Serial.println(micros());
  delay(100);
  startDisplayData();
  updateDisplayData();
}

void initTft(uint8_t rot){
  tft.setTextColor(ILI9341_WHITE, ILI9341_BLACK);
  screenRotation = rot;
  //tft.setFont(&FreeSans12pt7b);
  tft.setRotation(screenRotation);
  
  displayWidth    = tft.width();
  displayHeight   = tft.height();
  displayXCentre  = displayWidth/2;
  displayYCentre  = displayHeight/2;
  /*
   * Rotations 0 = vertical - with screen at top of ETRT
   *           1 = horizontal - with screen on left of ETRT
   *           2 = vertical - with screen at bottom of ETRT
   *           3 = horizontal - with screen on right of ETRT
   */
}

void startDisplayData(){
  tft.setTextColor(ILI9341_PURPLE, ILI9341_BLACK);
  tft.fillScreen(ILI9341_BLACK);
  printMessage("Enactive Torch RT\nPerceptual Crossing", 1,1,2);
  
  tft.setTextColor(ILI9341_BLUE, ILI9341_BLACK);
  String message1 = "X Count ";
  String message2 = "Y Count ";
  String message3 = "Button  ";
  String message4 = "XXX";
  //buttonState ? message4 = "ON " : message4 = "OFF";
  printMessage(message1, 1, 80, 2);
  printMessage(message2, 1, 130, 2);
  printMessage(message3, 1, 180, 2);
  
  //printMessage(message4, 150, 180, 2);
}
void autoUpdateTft(){
  if(millis() < nextDisplayUpdate) return;
  nextDisplayUpdate = millis() + displayUpdateInterval;
  updateTft();
}
void updateTft(){
  if(displayData) updateDisplayData();
  else if(animateData) displayAnimate();
}
void updateDisplayData(){
  //long st = millis();
  //Serial.println(millis());
  tft.setTextColor(ILI9341_OLIVE, ILI9341_BLACK);
  
  
  //tft.fillScreen(ILI9341_BLACK);
  String message1 = String(xCountTotal) + "      ";
  String message2 = String(yCountTotal) + "      ";
  String message3 = "XXX";
  buttonState ? message3 = "ON " : message3 = "OFF";
  
  //tft.setTextColor(ILI9341_WHITE, ILI9341_BLACK);
  if(xCountTotal != oldXCount){
    //tft.fillRect(150, 50, 20, 200, ILI9341_BLACK);
    printMessage(message1, 150, 80, 2);
    //displayAnimate();
  }
  if(yCountTotal != oldYCount){
    //tft.fillRect(150, 50, 20, 200, ILI9341_BLACK);
    printMessage(message2, 150, 130, 2);
  }
  if(buttonState != displayOldButtonState){
    //tft.fillRect(150, 50, 20, 200, ILI9341_BLACK);
    if(buttonState) tft.setTextColor(ILI9341_RED, ILI9341_BLACK);
    printMessage(message3, 150, 180, 2);
  }
  //if(xCountTotal != oldXCount) displayAnimate();
  displayOldButtonState = buttonState;
  //Serial.print("Time = ");
  //Serial.println(millis()-st);
}

void drawAgent(){
  //long st = micros();
  drawPos(xCountTotal%environmentSize);
  //long tt = micros()-st;
  //Serial.print("Time = ");
  //Serial.println(tt);
}
void drawPos(uint16_t pos){
  static uint16_t oldPos = xCountTotal%environmentSize;
  //5+(currentPos/2)
  tft.drawFastVLine(5+(oldPos/2), 200, 100, ILI9341_BLACK);
  tft.drawFastVLine(5+(pos/2), 200, 100, ILI9341_RED);
  
  oldPos = pos;
}


void setupAnimate(){
  posToAngle = (PI*2)/(float)environmentSize;
}

void displayAnimate(){
  //Display a line showing position as angle
  uint16_t currentPos = xCountTotal%environmentSize;
  float posAngle = (float)currentPos * posToAngle;
  //Use linear for now - easier maths!
  tft.fillRect(0, 220, displayWidth, 10, ILI9341_BLACK);
  tft.fillRect(5+(currentPos/2), 220, 10, 10, ILI9341_RED);
}
void clearPrintMessage(String message, int xStart, int yStart, uint8_t tSize){
  //long st = millis();
  clearScreen();
  printMessage(message, xStart, yStart, tSize);
  //long tt = millis()-st;
  //Serial.print("Time = ");
  //Serial.println(tt);
}

void printMessage(String message, int xStart, int yStart, uint8_t tSize){
 tft.setCursor(xStart, yStart);
 tft.setTextSize(tSize);
 tft.println(message);
}

void printTimerMessage(String message){
  //print in the middle of the screen
  //long st = millis();
  int x1 = 100, y1 = 100, w = 80 ,h = 30;
  tft.fillRect(x1,y1, w, h, ILI9341_BLACK);
  tft.setCursor(x1, y1);
  tft.setTextSize(4);
  tft.println(message);
  //long tt = millis()-st;
  //Serial.print("Time = ");
  //Serial.println(tt);
}

void clearScreen(){
 tft.fillScreen(ILI9341_BLACK);
 yield();
}


unsigned long testFillScreen() {
  unsigned long start = micros();
  tft.fillScreen(ILI9341_BLACK);
  yield();
  tft.fillScreen(ILI9341_RED);
  yield();
  tft.fillScreen(ILI9341_GREEN);
  yield();
  tft.fillScreen(ILI9341_BLUE);
  yield();
  tft.fillScreen(ILI9341_BLACK);
  yield();
  return micros() - start;
}

unsigned long testText() {
  tft.fillScreen(ILI9341_BLACK);
  unsigned long start = micros();
  tft.setCursor(0, 0);
  tft.setTextColor(ILI9341_WHITE);  tft.setTextSize(1);
  tft.println("Hello World!");
  tft.setTextColor(ILI9341_YELLOW); tft.setTextSize(2);
  tft.println(1234.56);
  tft.setTextColor(ILI9341_RED);    tft.setTextSize(3);
  tft.println(0xDEADBEEF, HEX);
  tft.println();
  tft.setTextColor(ILI9341_GREEN);
  tft.setTextSize(5);
  tft.println("Groop");
  tft.setTextSize(2);
  tft.println("I implore thee,");
  tft.setTextSize(1);
  tft.println("my foonting turlingdromes.");
  tft.println("And hooptiously drangle me");
  tft.println("with crinkly bindlewurdles,");
  tft.println("Or I will rend thee");
  tft.println("in the gobberwarts");
  tft.println("with my blurglecruncheon,");
  tft.println("see if I don't!");
  return micros() - start;
}

unsigned long testLines(uint16_t color) {
  unsigned long start, t;
  int           x1, y1, x2, y2,
                w = tft.width(),
                h = tft.height();

  tft.fillScreen(ILI9341_BLACK);
  yield();
  
  x1 = y1 = 0;
  y2    = h - 1;
  start = micros();
  for(x2=0; x2<w; x2+=6) tft.drawLine(x1, y1, x2, y2, color);
  x2    = w - 1;
  for(y2=0; y2<h; y2+=6) tft.drawLine(x1, y1, x2, y2, color);
  t     = micros() - start; // fillScreen doesn't count against timing

  yield();
  tft.fillScreen(ILI9341_BLACK);
  yield();

  x1    = w - 1;
  y1    = 0;
  y2    = h - 1;
  start = micros();
  for(x2=0; x2<w; x2+=6) tft.drawLine(x1, y1, x2, y2, color);
  x2    = 0;
  for(y2=0; y2<h; y2+=6) tft.drawLine(x1, y1, x2, y2, color);
  t    += micros() - start;

  yield();
  tft.fillScreen(ILI9341_BLACK);
  yield();

  x1    = 0;
  y1    = h - 1;
  y2    = 0;
  start = micros();
  for(x2=0; x2<w; x2+=6) tft.drawLine(x1, y1, x2, y2, color);
  x2    = w - 1;
  for(y2=0; y2<h; y2+=6) tft.drawLine(x1, y1, x2, y2, color);
  t    += micros() - start;

  yield();
  tft.fillScreen(ILI9341_BLACK);
  yield();

  x1    = w - 1;
  y1    = h - 1;
  y2    = 0;
  start = micros();
  for(x2=0; x2<w; x2+=6) tft.drawLine(x1, y1, x2, y2, color);
  x2    = 0;
  for(y2=0; y2<h; y2+=6) tft.drawLine(x1, y1, x2, y2, color);

  yield();
  return micros() - start;
}

unsigned long testFastLines(uint16_t color1, uint16_t color2) {
  unsigned long start;
  int           x, y, w = tft.width(), h = tft.height();

  tft.fillScreen(ILI9341_BLACK);
  start = micros();
  for(y=0; y<h; y+=5) tft.drawFastHLine(0, y, w, color1);
  for(x=0; x<w; x+=5) tft.drawFastVLine(x, 0, h, color2);

  return micros() - start;
}

unsigned long testRects(uint16_t color) {
  unsigned long start;
  int           n, i, i2,
                cx = tft.width()  / 2,
                cy = tft.height() / 2;

  tft.fillScreen(ILI9341_BLACK);
  n     = min(tft.width(), tft.height());
  start = micros();
  for(i=2; i<n; i+=6) {
    i2 = i / 2;
    tft.drawRect(cx-i2, cy-i2, i, i, color);
  }

  return micros() - start;
}

unsigned long testFilledRects(uint16_t color1, uint16_t color2) {
  unsigned long start, t = 0;
  int           n, i, i2,
                cx = tft.width()  / 2 - 1,
                cy = tft.height() / 2 - 1;

  tft.fillScreen(ILI9341_BLACK);
  n = min(tft.width(), tft.height());
  for(i=n; i>0; i-=6) {
    i2    = i / 2;
    start = micros();
    tft.fillRect(cx-i2, cy-i2, i, i, color1);
    t    += micros() - start;
    // Outlines are not included in timing results
    tft.drawRect(cx-i2, cy-i2, i, i, color2);
    yield();
  }

  return t;
}

unsigned long testFilledCircles(uint8_t radius, uint16_t color) {
  unsigned long start;
  int x, y, w = tft.width(), h = tft.height(), r2 = radius * 2;

  tft.fillScreen(ILI9341_BLACK);
  start = micros();
  for(x=radius; x<w; x+=r2) {
    for(y=radius; y<h; y+=r2) {
      tft.fillCircle(x, y, radius, color);
    }
  }

  return micros() - start;
}

unsigned long testCircles(uint8_t radius, uint16_t color) {
  unsigned long start;
  int           x, y, r2 = radius * 2,
                w = tft.width()  + radius,
                h = tft.height() + radius;

  // Screen is not cleared for this one -- this is
  // intentional and does not affect the reported time.
  start = micros();
  for(x=0; x<w; x+=r2) {
    for(y=0; y<h; y+=r2) {
      tft.drawCircle(x, y, radius, color);
    }
  }

  return micros() - start;
}

unsigned long testTriangles() {
  unsigned long start;
  int           n, i, cx = tft.width()  / 2 - 1,
                      cy = tft.height() / 2 - 1;

  tft.fillScreen(ILI9341_BLACK);
  n     = min(cx, cy);
  start = micros();
  for(i=0; i<n; i+=5) {
    tft.drawTriangle(
      cx    , cy - i, // peak
      cx - i, cy + i, // bottom left
      cx + i, cy + i, // bottom right
      tft.color565(i, i, i));
  }

  return micros() - start;
}

unsigned long testFilledTriangles() {
  unsigned long start, t = 0;
  int           i, cx = tft.width()  / 2 - 1,
                   cy = tft.height() / 2 - 1;

  tft.fillScreen(ILI9341_BLACK);
  start = micros();
  for(i=min(cx,cy); i>10; i-=5) {
    start = micros();
    tft.fillTriangle(cx, cy - i, cx - i, cy + i, cx + i, cy + i,
      tft.color565(0, i*10, i*10));
    t += micros() - start;
    tft.drawTriangle(cx, cy - i, cx - i, cy + i, cx + i, cy + i,
      tft.color565(i*10, i*10, 0));
    yield();
  }

  return t;
}

unsigned long testRoundRects() {
  unsigned long start;
  int           w, i, i2,
                cx = tft.width()  / 2 - 1,
                cy = tft.height() / 2 - 1;

  tft.fillScreen(ILI9341_BLACK);
  w     = min(tft.width(), tft.height());
  start = micros();
  for(i=0; i<w; i+=6) {
    i2 = i / 2;
    tft.drawRoundRect(cx-i2, cy-i2, i, i, i/8, tft.color565(i, 0, 0));
  }

  return micros() - start;
}

unsigned long testFilledRoundRects() {
  unsigned long start;
  int           i, i2,
                cx = tft.width()  / 2 - 1,
                cy = tft.height() / 2 - 1;

  tft.fillScreen(ILI9341_BLACK);
  start = micros();
  for(i=min(tft.width(), tft.height()); i>20; i-=6) {
    i2 = i / 2;
    tft.fillRoundRect(cx-i2, cy-i2, i, i, i/8, tft.color565(0, i, 0));
    yield();
  }

  return micros() - start;
}
