CreativeRobotics/EnactiveTorchRT2b/Firmware/DCU/FW Revision B/ETRT-DCU1/USER.ino

/*
 * DEFAULT Behaviour
 * WHen user switch is ON, SD card logging is enabled
 * When it is OFF SD logging is disabled
 * User button will toggle logging system on and off
 * Any enabled logs will be used when button toggles to ON, and stop when button toggles to off
 */
void updateUser(){
  //Update function for user editing
  userButtonAction(); //check for activity on the user button
  userSwitchAction(); //check for activity on the user slide switch
  if(device.buttonActionToggle && device.buttonActionToggleState) mapSensors();
  else if(device.userButtonState == true)  mapSensors();
  else noMapSensors();
}

//Some useful constants for positions in the inut and output arrays:
#define LIDAR_RANGE       2
#define SONAR_RANGE       2
#define VIB0_OUT          0
#define VIB1_OUT          1
#define AUDIO0_FREQ       2
#define AUDIO0_AMPLITUDE  3
#define AUDIO1_FREQ       4
#define AUDIO1_AMPLITUDE  5
/* UpdateInputs function
  if(device.sensorType == 1){
    device.inputs[0] = Sensor.getRange();
    device.inputs[1] = Sensor.getDelta();
    device.inputs[2] = Sensor.getTOFRange();
    device.inputs[3] = Sensor.getTOFDelta();
    device.inputs[4] = Sensor.getAuxRange();
    device.inputs[5] = Sensor.getAuxDelta();
  }else if(device.sensorType == 0){
    device.inputs[2] = getSonarRange();
  }
*/
  
void mapSensors(){
  //the main function for mapping sensor inputs to haptic outputs
  /*
  There are six input chanels and six output channels
  outputs 0-1 are vibration Strength
  outputs 2-3 and 4-5 are frequency and amplititude of analog output 0 and 1
  */
  updateInputs(); //copy current sensor values to the inputs array   
  float range = 150.0;
  if(device.sensorType == 0){
    //SONAR
    range = device.inputs[SONAR_RANGE];//SONAR range
  }
  else{
    //map TOF lidar range to Vib motor and transducer
    range = device.inputs[LIDAR_RANGE];//TOF LIDAR range
  }
  if(range > 150.0) range = 150.0;
  float vibIntensity = (150-range) * 0.0067;
  if(vibIntensity > 1.0) vibIntensity = 1.0;
  device.outputs[VIB0_OUT] = vibIntensity;
  device.outputs[VIB1_OUT] = vibIntensity;
  device.outputs[AUDIO0_FREQ] = device.audioFreq0;
  device.outputs[AUDIO1_FREQ] = device.audioFreq1;
  device.outputs[AUDIO0_AMPLITUDE] = vibIntensity;
  device.outputs[AUDIO1_AMPLITUDE] = vibIntensity;

  setOutputs(); //Apply the outputs array to the haptics system
}

void noMapSensors(){
  device.outputs[VIB0_OUT] = 0.0;
  device.outputs[VIB1_OUT] = 0.0;
  device.outputs[AUDIO0_AMPLITUDE] = 0.0;
  device.outputs[AUDIO1_AMPLITUDE] = 0.0;
  setOutputs(); //Apply the outputs array to the haptics system
}
//===============================================================================================

void userSwitchAction(){
  if(device.userSwitchChanged == false) return; //do nothing if it hasn't changed
  device.userSwitchChanged = false; //reset the change flag
  //Do something because the switch has changed
  if(device.userSwitchState == true){
    device.logSD = true;
  }else if(device.userSwitchState == false){
    device.logSD = false;
  }
}
//===============================================================================================
void userButtonAction(){
  if(!device.userButtonChanged) return;
  device.userButtonChanged = false;
  if(device.buttonActionToggle) buttonToggle();
  else if(device.userButtonState)  buttonOnAction();
  else if(!device.userButtonState) buttonOffAction();
}

void buttonToggle(){
  if(!device.userButtonState) return; //if switch released, do nothing
  device.buttonActionToggleState = !device.buttonActionToggleState;
  if(!device.buttonActionToggleState) buttonOffAction(); //turn off
  else buttonOnAction(); //turn on
  if(DBG.STD) {
    DEBUG.print("Button Toggle ");
    device.buttonActionToggleState ? DEBUG.println("TON") : DEBUG.println("TOFF");
  }
  return;
}
//===============================================================================================
void buttonOnAction(){
  setLEDs(blueLED);
  if(device.buttonEnableHaptics){
    //testHapticsStart();
    enableAudio();
    if(DBG.STD) DEBUG.println("DEBUG: Button: Haptics On");
  }
  if(device.buttonStartLog){
    startLog();
    if(DBG.STD) DEBUG.println("DEBUG: Button: Log On");
  }
}
//===============================================================================================

void buttonOffAction(){
  setLEDs(whiteLED);
  if(device.buttonEnableHaptics){
    //testHapticsStop();
    //beepOff();
    disableAudio();
    if(DBG.STD) DEBUG.println("DEBUG: Button: Haptics Off");
  }
  if(device.buttonStartLog){
    stopLog();
    if(DBG.STD) DEBUG.println("DEBUG: Button: Log Off");
  }
}
