CreativeRobotics/EnactiveTorchRT2b/(commit log)

2020-02-21 Initial release
    Enactive Torch RT2 hardware revision b. Includes perceptual crossing software for the ETRT DCU perceptual crossing attachement.
2020-03-21 Bug fix for Sonar
    Bug fix for sonar not reporting in cm, also updated Cmmmander to latest version, fixed some other minor bugs and updated debugging options.
    [CommandHandlers.ino, Commander.h, DCU_States.ino, DataLogging.ino, ETRT-DCU.h, ETRT-DCU1.ino, IOModules.ino, SDCard.ino]
2020-05-08 Update to 1.2.0
    See readme.md for fixes and the updated debug commands.
    [CommandHandlers.ino, Commander.h, DCU_States.ino, DataLogging.ino, ETRT-DCU.h, ETRT-DCU1.ino, IMU.ino, SDCard.ino]
2020-08-28 Update to include new revision
    There are two versions of both firmwares (ESP32 and DCU). DCU version 1.2 or greater is designed to work with ESP32 version 3.1. All versions have an undated COmmander library that fixes an issue where sub commands that relied on the ON and OFF keywords did not work properly.
    Both ESP32 versions support over the air firmware updates, however the process has proved unreliable. A method of updating the firmware using the DCU is being developed.
    [CommandHandlers.ino, Commander.h, Commander.ino, DCU_States.ino, DataLogging.ino, ETRT-DCU.h, ETRT-DCU1.ino, ETRT_ESP_Globals.h]
2020-09-07 Corrected revision names from 1&2 to A%B
    [CommandHandlers.ino, Commander.h, DCU_States.ino, DataLogging.ino, ETRT-DCU.h, ETRT-DCU1.ino, IMU.ino, IOModules.ino]
